WehningM/EspressoBoardB/Espressomaschine Board B/Espressomaschine Board B.kicad_sch

## KiCad design Espressomaschine Board B/Espressomaschine Board B.kicad_sch (2026-10-12)

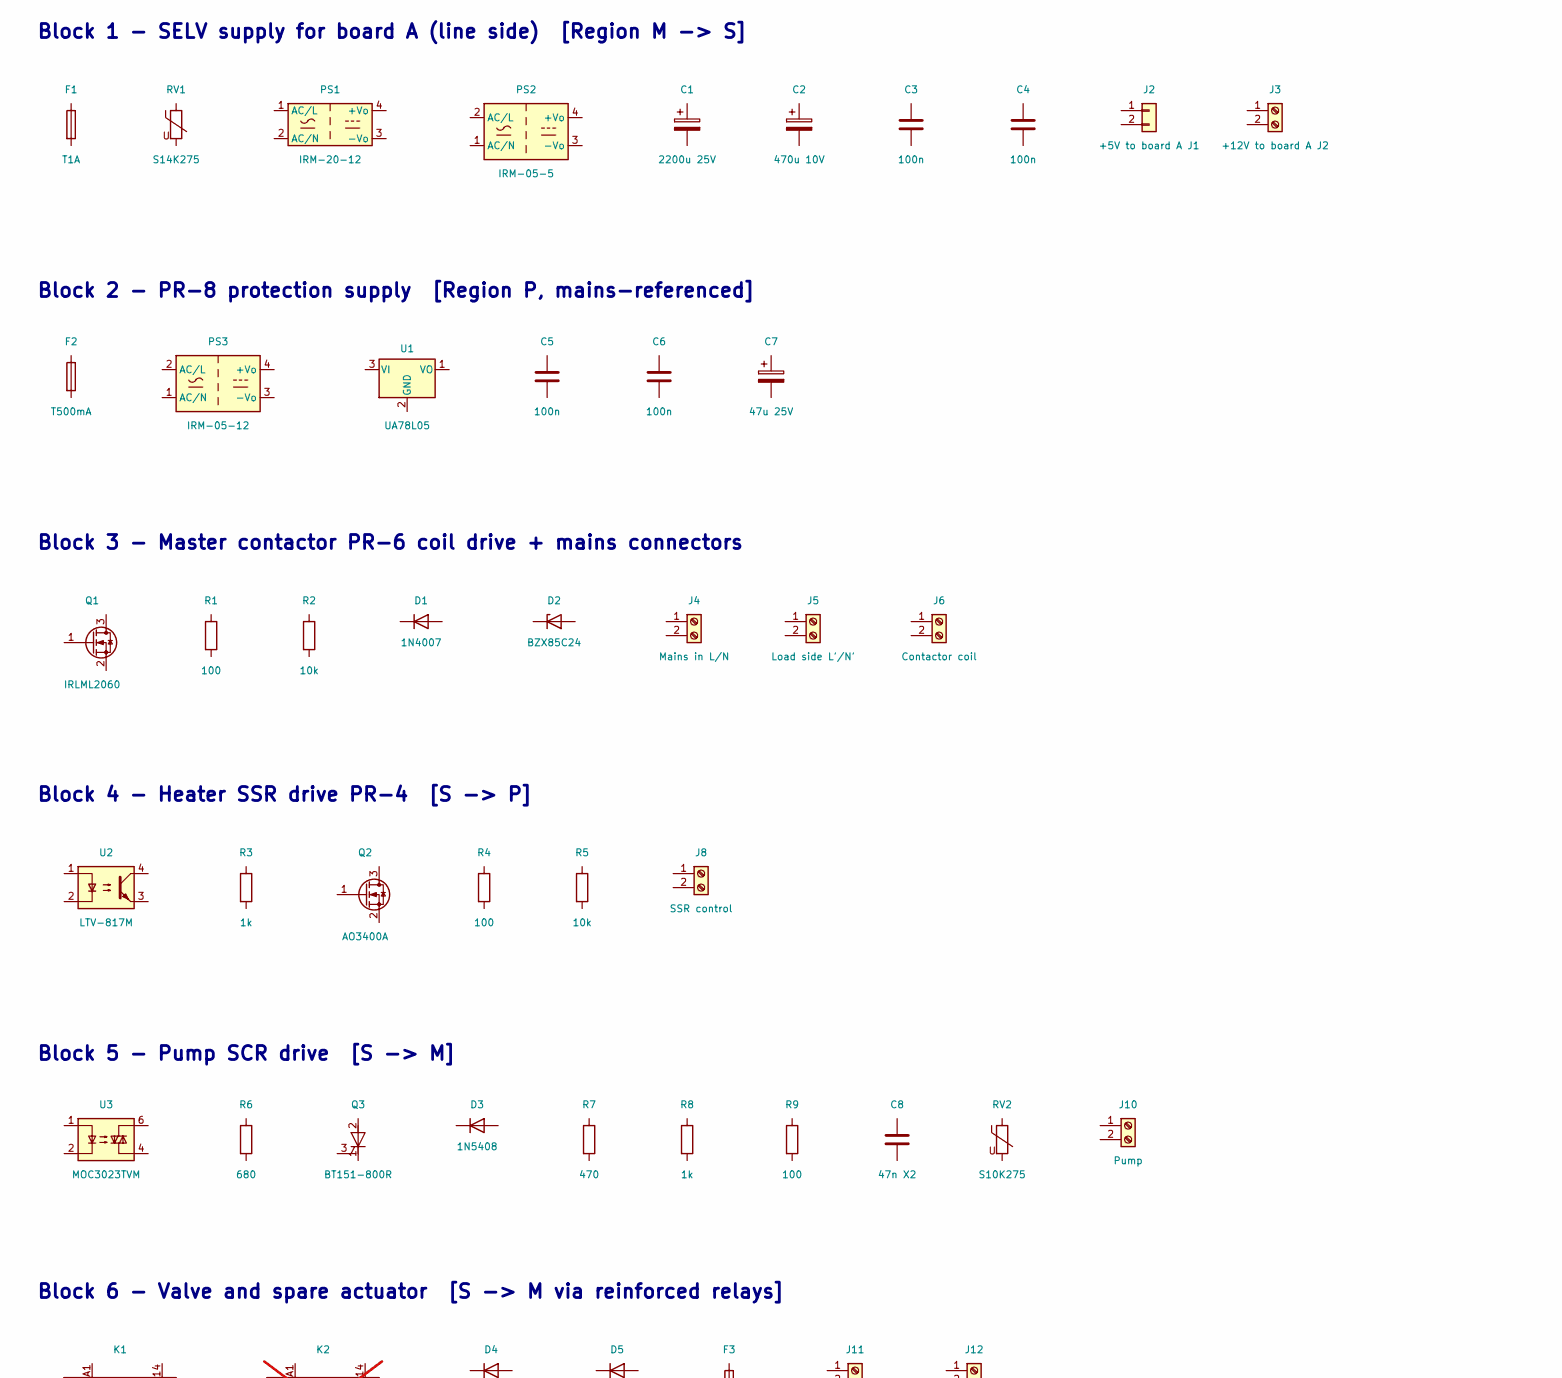
[picture p1: schematic Espressomaschine Board B.kicad_sch, part in row 1, column 1]

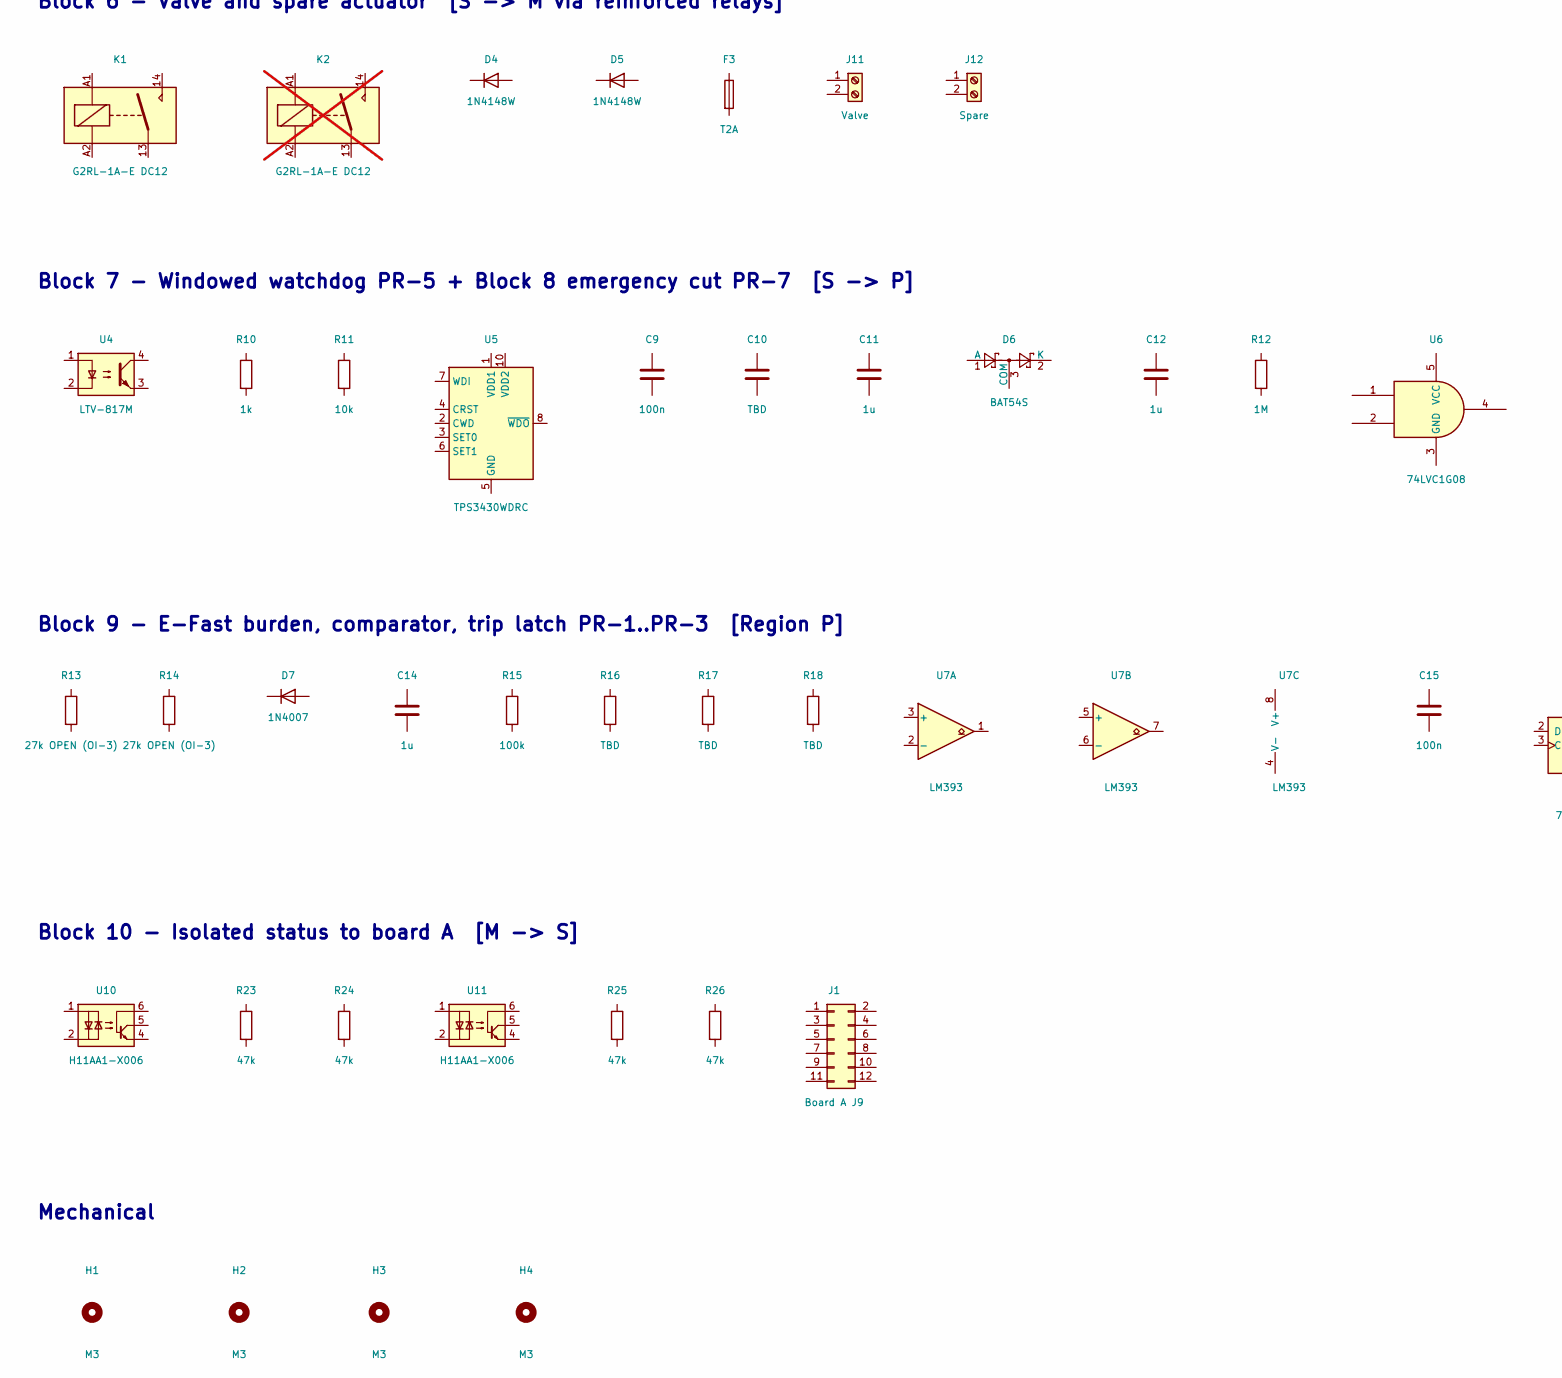
[picture p2: schematic Espressomaschine Board B.kicad_sch, part in row 2, column 1]

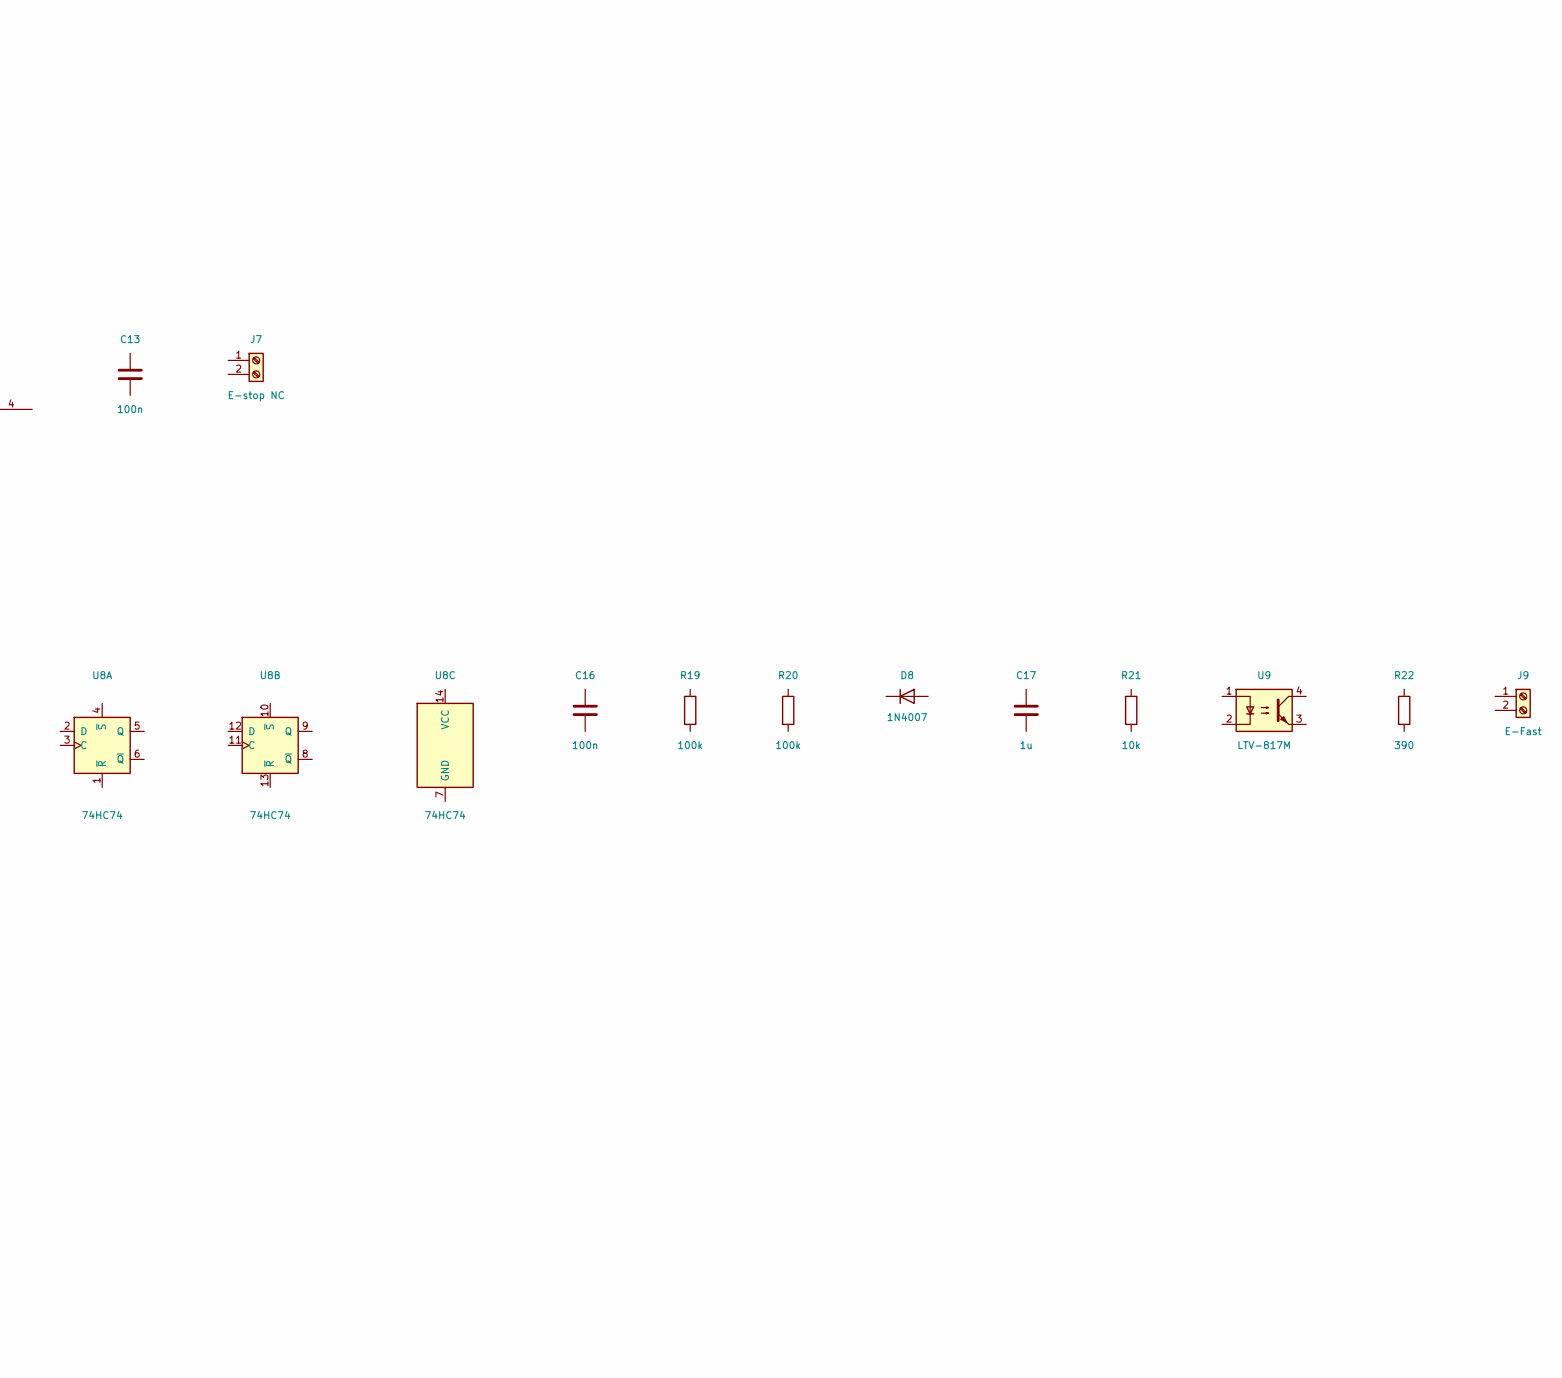
[picture p3: schematic Espressomaschine Board B.kicad_sch, part in row 2, column 2]

Parts:
C1: 2200u 25V; CP_Radial_D16.0mm_P7.50mm; MPN UVR1E222MHD
C2: 470u 10V; CP_Radial_D8.0mm_P3.50mm; MPN UVR1A471MED
C3, C4, C5, C6, C9, C13, C15, C16: 100n; C_0805_2012Metric; MPN C0805C X7R 100n
C7: 47u 25V; CP_Radial_D5.0mm_P2.00mm; MPN UVR1E470MDD
C8: 47n X2; C_Rect_L13.0mm_W5.0mm_P10.00mm_FKS3_FKP3_MKS4; MPN B32921C3473M189
C10: TBD; C_0805_2012Metric; MPN C0805C X7R TBD
C11, C12, C14, C17: 1u; C_0805_2012Metric; MPN C0805C X7R 1u
D1, D7, D8: 1N4007; D_DO-41_SOD81_P10.16mm_Horizontal; MPN 1N4007
D2: BZX85C24; D_DO-41_SOD81_P10.16mm_Horizontal; MPN BZX85C24
D3: 1N5408; D_DO-201AD_P15.24mm_Horizontal; MPN 1N5408
D4, D5: 1N4148W; D_SOD-123; MPN 1N4148W-7-F
D6: BAT54S; SOT-23; MPN BAT54S-7-F
F1: T1A; Fuseholder_Clip-5x20mm_Schurter_CQM_Inline_P20.60x5.00mm_D1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; MPN FST 5x20 T1A
F2: T500mA; Fuseholder_Clip-5x20mm_Schurter_CQM_Inline_P20.60x5.00mm_D1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; MPN FST 5x20 T500mA
F3: T2A; Fuseholder_Clip-5x20mm_Schurter_CQM_Inline_P20.60x5.00mm_D1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; MPN FST 5x20 T2A
H1, H2, H3, H4: M3; MountingHole_3.2mm_M3
J1: Board A J9; IDC-Header_2x06_P2.54mm_Horizontal; MPN 2.54-2*6P
J2: +5V to board A J1; JST_XH_B2B-XH-A_1x02_P2.50mm_Vertical; MPN B2B-XH-A(LF)(SN)
J3: +12V to board A J2; TerminalBlock_MetzConnect_Type011_RT05502HBLC_1x02_P5.00mm_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; MPN KF301-5.0-2P
J4: Mains in L/N; TerminalBlock_MetzConnect_Type011_RT05502HBLC_1x02_P5.00mm_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; MPN KF301-5.0-2P
J5: Load side L'/N'; TerminalBlock_MetzConnect_Type011_RT05502HBLC_1x02_P5.00mm_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; MPN KF301-5.0-2P
J6: Contactor coil; TerminalBlock_MetzConnect_Type011_RT05502HBLC_1x02_P5.00mm_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; MPN KF301-5.0-2P
J7: E-stop NC; TerminalBlock_MetzConnect_Type011_RT05502HBLC_1x02_P5.00mm_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; MPN KF301-5.0-2P
J8: SSR control; TerminalBlock_MetzConnect_Type011_RT05502HBLC_1x02_P5.00mm_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; MPN KF301-5.0-2P
J9: E-Fast; TerminalBlock_MetzConnect_Type011_RT05502HBLC_1x02_P5.00mm_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; MPN KF301-5.0-2P
J10: Pump; TerminalBlock_MetzConnect_Type011_RT05502HBLC_1x02_P5.00mm_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; MPN KF301-5.0-2P
J11: Valve; TerminalBlock_MetzConnect_Type011_RT05502HBLC_1x02_P5.00mm_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; MPN KF301-5.0-2P
J12: Spare; TerminalBlock_MetzConnect_Type011_RT05502HBLC_1x02_P5.00mm_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; MPN KF301-5.0-2P
K1: G2RL-1A-E DC12; Relay_SPST_Omron_G2RL-1A-E; MPN G2RL-1A-E DC12
K2: G2RL-1A-E DC12; Relay_SPST_Omron_G2RL-1A-E; MPN G2RL-1A-E DC12; not fitted
PS1: IRM-20-12; Converter_ACDC_MeanWell_IRM-20-xx_THT; MPN IRM-20-12
PS2: IRM-05-5; Converter_ACDC_MeanWell_IRM-05-xx_THT; MPN IRM-05-5
PS3: IRM-05-12; Converter_ACDC_MeanWell_IRM-05-xx_THT; MPN IRM-05-12
Q1: IRLML2060; SOT-23; MPN IRLML2060TRPBF
Q2: AO3400A; SOT-23; MPN AO3400A
Q3: BT151-800R; TO-220-3_Vertical; MPN BT151-800R,127
R1, R4: 100; R_0805_2012Metric; MPN CRCW0805 100
R2, R5, R11, R21: 10k; R_0805_2012Metric; MPN CRCW0805 10k
R3, R8, R10: 1k; R_1206_3216Metric; MPN CRCW1206 1k
R6: 680; R_1206_3216Metric; MPN CRCW1206 680
R7: 470; R_Axial_DIN0207_L6.3mm_D2.5mm_P10.16mm_Horizontal; MPN PR01 470R
R9: 100; R_Axial_DIN0207_L6.3mm_D2.5mm_P10.16mm_Horizontal; MPN PR01 100R
R12: 1M; R_0805_2012Metric; MPN CRCW0805 1M
R13, R14: 27k OPEN (OI-3); R_Axial_DIN0207_L6.3mm_D2.5mm_P10.16mm_Horizontal; MPN VR25 (value per OI-3)
R15: 100k; R_0805_2012Metric; MPN CRCW0805 100k
R16, R17, R18: TBD; R_0805_2012Metric; MPN CRCW0805 TBD
R19, R20: 100k; R_Axial_DIN0207_L6.3mm_D2.5mm_P10.16mm_Horizontal; MPN VR25 100k
R22: 390; R_1206_3216Metric; MPN CRCW1206 390
R23, R24, R25, R26: 47k; R_Axial_DIN0207_L6.3mm_D2.5mm_P10.16mm_Horizontal; MPN PR01 47k
RV1: S14K275; RV_Disc_D15.5mm_W5.9mm_P7.5mm; MPN B72214S0271K101
RV2: S10K275; RV_Disc_D12mm_W5.4mm_P7.5mm; MPN B72210S0271K101
U1: UA78L05; TO-92_Inline; MPN UA78L05ACLPR
U2, U4, U9: LTV-817M; DIP-4_W10.16mm; MPN LTV-817M
U3: MOC3023TVM; DIP-6_W10.16mm; MPN MOC3023TVM
U5: TPS3430WDRC; VSON-10-1EP_3x3mm_P0.5mm_EP1.65x2.4mm; MPN TPS3430WDRCR
U6: 74LVC1G08; SOT-23-5; MPN SN74LVC1G08DBVR
U7: LM393; SOIC-8_3.9x4.9mm_P1.27mm; MPN LM393DR
U8: 74HC74; SOIC-14_3.9x8.7mm_P1.27mm; MPN 74HC74D
U10, U11: H11AA1-X006; DIP-6_W10.16mm; MPN H11AA1-X006

Connections:
unnamed: U5.5 (GND), U5.11 (GND)

Notes on the sheet:
Block 1 - SELV supply for board A (line side) [Region M -> S]
Block 2 - PR-8 protection supply [Region P, mains-referenced]
Block 3 - Master contactor PR-6 coil drive + mains connectors
Block 4 - Heater SSR drive PR-4 [S -> P]
Block 5 - Pump SCR drive [S -> M]
Block 6 - Valve and spare actuator [S -> M via reinforced relays]
Block 7 - Windowed watchdog PR-5 + Block 8 emergency cut PR-7 [S -> P]
Block 9 - E-Fast burden, comparator, trip latch PR-1..PR-3 [Region P]
Block 10 - Isolated status to board A [M -> S]
Mechanical
